boticxlab-llp/HOPE_COUNTER_V3_0922/hw/BOM_HOPE_LAYOUT_V3_2022-09-04.csv

ID | Name | Designator | Footprint | Quantity | Manufacturer Part | Manufacturer | Supplier | Supplier Part | Price
1 | 330Ω | R11,R2,R4,R5 | R0805 | 4 | 0805W8F3300T5E | UniOhm | LCSC | C17630 | 0.002
2 | 10K | R12,R6,R7,R8,R9,R10 | R1206 | 6 | RC1206FR-0710KL | YAGEO | LCSC | C132649 | 0.003
3 | 10uF | C1,C2,C3,C4 | CAP-SML-10UF | 4 | 10uF 450V 13*20 | ValuePro | LCSC | C46886 | 0.131
4 | 100nF | C5,C6 | C0805 | 2 | 0805B104K500 | WTC | LCSC | C83055 | 0.006
5 | 10nF | C7,C9 | C0805 | 2 | CC0805KRX7R9BB103 | YAGEO | LCSC | C83170 | 0.004
6 | 4.7uf | C8 | CAP-TH_BD10.0-P5.00-D0.6-FD | 1 | 450CFX4.7MEFC10X16 | rubycon(红宝石) | LCSC | C5115122 | 0.281
7 | 1uF | C10 | C0805 | 1 | CL21B105KBFNNNE | SAMSUNG | LCSC | C28323 | 0.005
8 | 100nF | C11 | C0805 | 1 | 08051C104KAT2A | AVX | LCSC | C597290 | 0.019
9 | 22pF | C12,C13 | C0603 | 2 | CC0603JRNPO9BN220 | YAGEO | LCSC | C105620 | 0.002
10 | SPI | CN1 | HDR-TH_6P-P2.54-H-M-R2-C3-S2.00_HEADER-2X3-2D54 | 1 | header-2x3-2d54 | null | LCSC | C9900010486
11 | INPUT_SUPPLY | JP1,JP2 | SCREWTERMINAL-5MM-2 | 2
12 | RED | LED1,LED4 | LED0805-R-RD | 2 | 17-21SURC/S530-A3/TR8 | EVERLIGHT | LCSC | C72037 | 0.017
13 | 19-217/GHC-YR1S2/3T | LED2,LED3 | LED0603-R-RD | 2 | 19-217/GHC-YR1S2/3T | EVERLIGHT | LCSC | C72043 | 0.028
14 | PROGRAM | P1 | HDR-TH_4P-P2.54-V-M-1 | 1 | HEADER_1*4P | null | LCSC | C9900003200
15 | POWER | P2,P5 | HDR-TH_2P-P2.00-V-F-1 | 2 | Female header1*2P | BOOMELE | LCSC | C66509 | 0.046
16 | UART | P4 | HDR-TH_4P-P2.54-V-M-1 | 1 | HEADER_1*4P | null | LCSC | C9900003200
17 | I2C | P6 | HDR-TH_4P-P2.54-V-M-1 | 1 | HEADER_1*4P | null | LCSC | C9900003200
18 | TRIMPOTPTH | R1,R3 | TRIM_POT_PTH | 2
19 | 3.3K | R13,R14 | R0805 | 2 | RC0805FR-073K3L | YAGEO | LCSC | C114531 | 0.002
20 | RESET | SW1 | KEY-TH_4P-L6.0-W6.0-P3.90-LS6.5 | 1 | TS-1095PD-A8B2-D2 | Yuandi(台湾元迪) | LCSC | C2834879 | 0.05
21 | GPIO | SW2 | KEY-TH_4P-L6.0-W6.0-P3.90-LS6.5 | 1 | TS-1095PD-A8B2-D2 | Yuandi(台湾元迪) | LCSC | C2834879 | 0.05
22 | RCU-0C | TP1,TP2,TP3,TP4 | TESTPOINT-SMD_L1.6-W0.8_RCU-0C | 4 | RCU-0C | null | LCSC | C9900019498
23 | AMS117-5V | U1 | AMS117-TOPL | 1
24 | AMS1117-3.3V | U2 | SOT-223-4_L6.5-W3.5-P2.30-LS7.0-BR | 1 | AMS1117-3.3V | WPMtek(维攀微) | LCSC | C2688239 | 0.074
25 | LM358P | U3 | DIP-8_L9.4-W6.4-P2.54-LS9.1-BL | 1 | LM358P | TI | LCSC | C5213 | 0.218
26 | TP | U4,U8 | TESTPOINT-TH_BD3.2 | 2 | TP-黄色测试点 | null | LCSC | C9900007422
27 | STM32F030K6T6 | U5 | LQFP-32_L7.0-W7.0-P0.80-LS9.0-BL | 1 | 国产杂牌直代兼容STM32F030K6T6芯片 | null | LCSC | C9900013701
28 | LCD20X4Sym | U6 | LCD20X4FP | 1
29 | HDR-1X5. | U7 | CONN-TH_HDR-1X5 | 1 | HDR-1X5插件 | null | LCSC | C2935751
30 | - | X2 | HC-49US_L11.5-W4.5-P4.88 | 1 | XIHCELNANF-8MHZ | TAITIEN Elec | LCSC | C295088 | 0.147
