boticxlab-llp/HOPE_COUNTER_V3_0922/hw/hope_v3_schematic.pdf

+12v

### GND

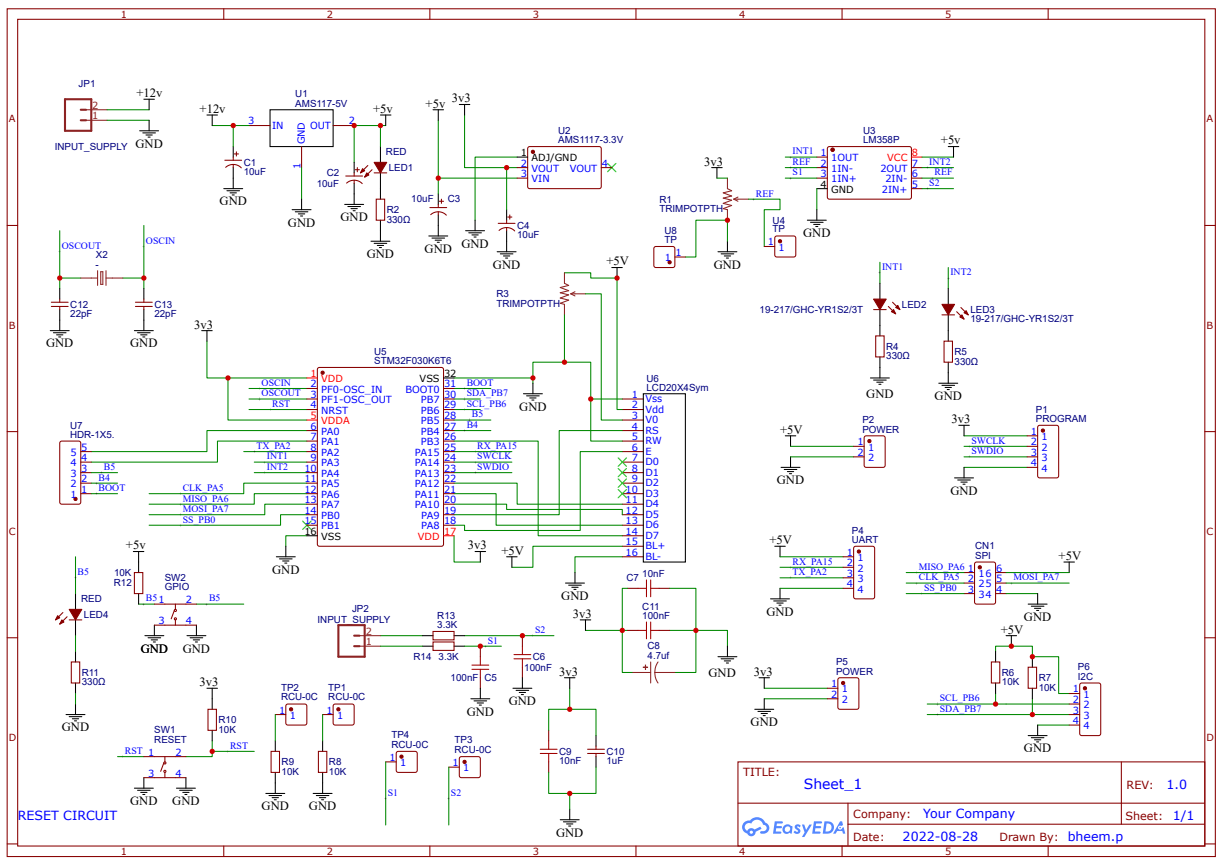
[picture p1: page 1]
