boticxlab-llp/HOPE_COUNTER_V3_0922/hw/PCB_HOPE_LAYOUT_V3_layout.pdf

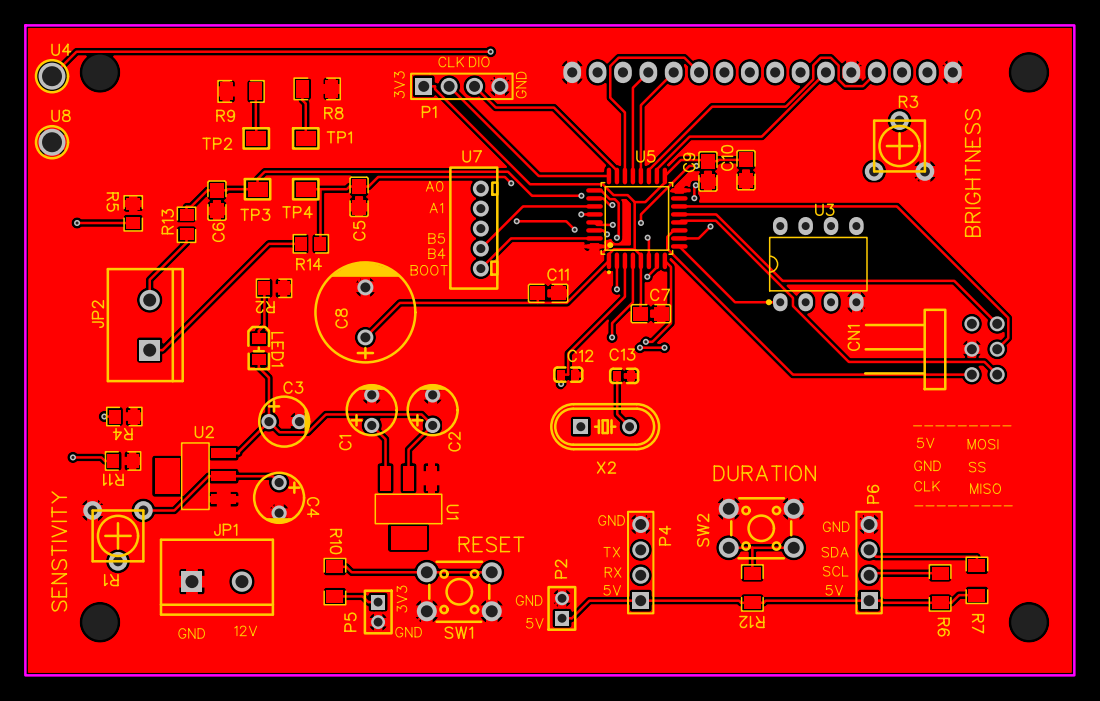
[picture p2: page 1]
