boticxlab-llp/HOPE_COUNTER_V3_0922/Core/Src/main.c

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
/* Includes ------------------------------------------------------------------*/
#include "main.h"

/* USER CODE BEGIN Includes */
#include "stdio.h"
#include "../Lib/lcd.h"
/* USER CODE END Includes */

 TIM_HandleTypeDef htim14;

UART_HandleTypeDef huart1;

/* USER CODE BEGIN PV */
 void lcd_default(void);
 void print_value(int val);
 void lcd_print(void);
 void lcd_print_data(void);

 int net = 0;
 uint32_t total = 0;
 uint16_t in = 0, out = 0;

 uint32_t t1 = 0, t0 = 0;
 uint32_t timeout = 700;

 const char title[50] = "HOPE SEC EQP PVT LTD";
/* USER CODE END PV */

void SystemClock_Config(void);
static void MX_GPIO_Init(void);
static void MX_TIM14_Init(void);
static void MX_USART1_UART_Init(void);
static void MX_NVIC_Init(void);
/* USER CODE BEGIN PFP */

const LCD16x2_CfgType LCD16x2_CfgParam =
{
	GPIOA,
	GPIO_PIN_12,
	GPIO_PIN_10,
	GPIO_PIN_11,
	GPIO_PIN_3,
	GPIO_PIN_8,
	GPIO_PIN_9,
	2
};

const LCD16x2_CfgType LCD16x2_CfgParam;


void delay_ms (uint16_t ms)
{
	__HAL_TIM_SET_COUNTER(&htim14,0);  // set the counter value a 0
	while (__HAL_TIM_GET_COUNTER(&htim14) < ms);  // wait for the counter to reach the us input in the parameter
}
/* USER CODE END PFP */

/* USER CODE BEGIN 0 */
void HAL_GPIO_EXTI_Callback(uint16_t GPIO_Pin)
{
    if(GPIO_Pin == GPIO_PIN_3) // If The INT Source Is EXTI Line9 (A9 Pin)
    {

    	  static uint32_t last_interrupt_time = 0;
    	  uint32_t interrupt_time = HAL_GetTick(); //millis();

    	  // If interrupts come faster than 200ms, assume it's a bounce and ignore
    	  //   noInterrupts();
    	  if ((interrupt_time - last_interrupt_time) > timeout)
    	  {
    	    t1 = HAL_GetTick(); //millis();
    	  }
    	  last_interrupt_time = interrupt_time;
    }

    if(GPIO_Pin == GPIO_PIN_4) // If The INT Source Is EXTI Line9 (A9 Pin)
    {
    	  static uint32_t last_interrupt_time = 0;
    	  uint32_t interrupt_time = HAL_GetTick();  //millis();
    	  // noInterrupts();
    	  // If interrupts come faster than 200ms, assume it's a bounce and ignore
    	  if ((interrupt_time - last_interrupt_time) > timeout) // && (int0_flag == 0
    	  {
    	    t0 = HAL_GetTick(); //millis();
    	  }
    	  last_interrupt_time = interrupt_time;
    }
}


/************************** LCD function *****************************/
void print_value(int val)
{
  char buff[50];
  sprintf(buff, "%06d", val);
  LCD_Write_String(buff);
}

void lcd_print_data()
{
  net = in - out;

//  if(net < 0)
//  {
//	  net = 0;
//  }
  total = in + out;
  // lcd.clear();
  LCD_Set_Cursor(5, 1);
  // LCD_Write_String(in);
  print_value(in);

  LCD_Set_Cursor(5, 2);
  // LCD_Write_String(out);
  print_value(out);

  //  count= count_in-count_out;
  LCD_Set_Cursor(5, 3);
  print_value(net);

  LCD_Set_Cursor(14, 3);
  print_value(total);
}

void lcd_print()
{
  net = in - out;
  total = in + out;
  LCD_Clear();
  LCD_Set_Cursor(0, 0);
  // lcd.scrollDisplayLeft(&title[0]);
  LCD_Write_String("HOPE SEC EQP PVT LTD");
  LCD_Set_Cursor(0, 1);
  LCD_Write_String("IN ");
  LCD_Set_Cursor(5, 1);
  //  LCD_Write_String(in);
  print_value(in);
  LCD_Set_Cursor(0, 2);
  LCD_Write_String("OUT ");
  LCD_Set_Cursor(5, 2);
  // LCD_Write_String(out);
  print_value(out);
  LCD_Set_Cursor(0, 3);
  LCD_Write_String("NET ");
  LCD_Set_Cursor(5, 3);
  print_value(net);
  // LCD_Write_String(0);

  LCD_Set_Cursor(14, 2);
  LCD_Write_String("TOTAL");

  LCD_Set_Cursor(14, 3);
  print_value(total);
  // LCD_Write_String(0);
}

void lcd_default()
{

//  lcd.begin(20, 4);
  LCD_Set_Cursor(0, 0);
  // lcd.scrollDisplayLeft(&title[0]);
  LCD_Write_String("HOPE SEC EQP PVT LTD");
  LCD_Set_Cursor(0, 1);
  LCD_Write_String("IN ");
  LCD_Set_Cursor(5, 1);
  // LCD_Write_String(0);
  print_value(0);
  LCD_Set_Cursor(0, 2);
  LCD_Write_String("OUT ");
  LCD_Set_Cursor(5, 2);
  // LCD_Write_String(0);
  print_value(0);
  LCD_Set_Cursor(0, 3);
  LCD_Write_String("NET ");
  LCD_Set_Cursor(5, 3);
  // LCD_Write_String(0);
  print_value(0);

  LCD_Set_Cursor(15, 2);
  LCD_Write_String("TOTAL");

  LCD_Set_Cursor(14, 3);
  // LCD_Write_String(0);
  print_value(0);
}



/****************************** end of code *****************/
/* USER CODE END 0 */

/**
  * @brief  The application entry point.
  * @retval int
  */
int main(void)
{
  /* MCU Configuration--------------------------------------------------------*/

  /* Reset of all peripherals, Initializes the Flash interface and the Systick. */
  HAL_Init();

  /* Configure the system clock */
  SystemClock_Config();

  /* Initialize all configured peripherals */
  MX_GPIO_Init();
  MX_TIM14_Init();
  MX_USART1_UART_Init();

  /* Initialize interrupts */
  MX_NVIC_Init();
  /* USER CODE BEGIN 2 */
  HAL_TIM_Base_Start(&htim14); // START TIMER
//  uint8_t Test[] = ".............Setup Ready........... !!!\r\n"; //Data to send
//  HAL_UART_Transmit(&huart1,Test,sizeof(Test),10);// Sending in normal mode
//  HAL_GPIO_TogglePin(GPIOC, GPIO_PIN_13);
  LCD_Init();
  LCD_Clear();

  LCD_Set_Cursor(5, 0);
  LCD_Write_String("BOOTING");

  LCD_Set_Cursor(5, 1);
  LCD_Write_String("PLEASE");

  LCD_Set_Cursor(5, 2);
  LCD_Write_String("WAIT");
  delay_ms(7000);
  char buffer[50];

  lcd_default();
  uint8_t flag = 0;

  int a = 10;
  int b = 10;
  /* USER CODE END 2 */

  /* Infinite loop */
  /* USER CODE BEGIN WHILE */
  while (1)
  {
    /* USER CODE END WHILE */

    /* USER CODE BEGIN 3 */
	  if(flag)
	  {
		  HAL_GPIO_WritePin(GPIOB, GPIO_PIN_5, 1);
		  HAL_Delay(1000);
		  HAL_GPIO_WritePin(GPIOB, GPIO_PIN_5, 0);
		  flag = 0;
	  }
//	  HAL_GPIO_TogglePin(GPIOB, GPIO_PIN_5);

//	  HAL_Delay(500);
	  if ((HAL_GetTick() - t1) < timeout && (HAL_GetTick() - t0) < timeout)
	  {

	    if (t1 > t0)
	    {
	      in++;
//	      Serial.print("IN :");
//	      Serial.println(in);
//	      sprintf(buffer, " %d /%d",in,out);
//		    sprintf(buffer, "%d-%d=",in,out);
//	//	    strcat(buffer, '\0');
//		    HAL_UART_Transmit(&huart1,buffer,sizeof(buffer),10);// Sending in normal mode
	      t0 = 0;
	      t1 = 0;
	      flag = 1;
	    }

	    else
	    {
	      out++;
//		    sprintf(buffer, "%d-%d=",in,out);
//	//	    strcat(buffer, '\0');
//		    HAL_UART_Transmit(&huart1,buffer,sizeof(buffer),10);// Sending in normal mode
//	      sprintf(buffer, " %d /%d", out);
//	      Serial.print("OUT :");
//	      Serial.println(out);
	      t0 = 0;
	      t1 = 0;
	      flag = 1;
	    }

	    sprintf(buffer, "%d,%d,%d,%d=",in,out,in-out,in+out);
	//	    strcat(buffer, '\0');
		    HAL_UART_Transmit(&huart1,buffer,sizeof(buffer),10);// Sending in normal mode

	  }

	    HAL_Delay(10);
//	    sprintf(buffer, "%d,%d,%d,%d=",in,out,in-out,in+out);
//	 	//	    strcat(buffer, '\0');
//	 		    HAL_UART_Transmit(&huart1,buffer,sizeof(buffer),10);// Sending in normal mode
//	  sprintf(buffer, "%d-%d,",a,b);
//		//	    strcat(buffer, '\0');
//	  HAL_UART_Transmit(&huart1,buffer,sizeof(buffer),100);// Sending in normal mode

//	    sprintf(buffer, "%d,%d,%d,%d=",99,98,97,96);
////	   	//	    strcat(buffer, '\0');
//	   		    HAL_UART_Transmit(&huart1,buffer,sizeof(buffer),10);// Sending in normal mode
//	  HAL_Delay(1000);
	  lcd_print_data();


  }
  /* USER CODE END 3 */
}

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
