boticxlab-llp/HOPE_COUNTER_V3_0922/Core/Inc/main.h

#define INT1_Pin GPIO_PIN_3
#define INT1_GPIO_Port GPIOA
#define INT1_EXTI_IRQn EXTI2_3_IRQn
#define INT2_Pin GPIO_PIN_4
#define INT2_GPIO_Port GPIOA
#define INT2_EXTI_IRQn EXTI4_15_IRQn
#define EN_Pin GPIO_PIN_8
#define EN_GPIO_Port GPIOA
#define RS_Pin GPIO_PIN_9
#define RS_GPIO_Port GPIOA
#define D5_Pin GPIO_PIN_10
#define D5_GPIO_Port GPIOA
#define D6_Pin GPIO_PIN_11
#define D6_GPIO_Port GPIOA
#define D4_Pin GPIO_PIN_12
#define D4_GPIO_Port GPIOA
#define D7_Pin GPIO_PIN_3
#define D7_GPIO_Port GPIOB
