boticxlab-llp/HOPE_COUNTER_V3_0922/(commit log)

2022-09-18 hardware dir created
    [BOM_HOPE_LAYOUT_V3_2022-09-04.csv]
2023-04-05 first esp32
