boticxlab-llp/HOPE_COUNTER_V3_0922/(notices)

Notices in the files:
Core/Src/main.c:
Copyright (c) 2022 STMicroelectronics.
All rights reserved.
This software is licensed under terms that can be found in the LICENSE file
